stuartpittaway/diyBMS-CurrentShunt/(notices)

Notices in the files:
CurrentShuntCircuit/CurrentShuntCircuit.kicad_pcb:
Design (c)2021 Stuart Pittaway
This work is licensed under a
Creative Commons
Attribution NonCommercial ShareAlike
